marcelobns/sentinela-ip-core/docs/evidencias/alu8_circuito.png

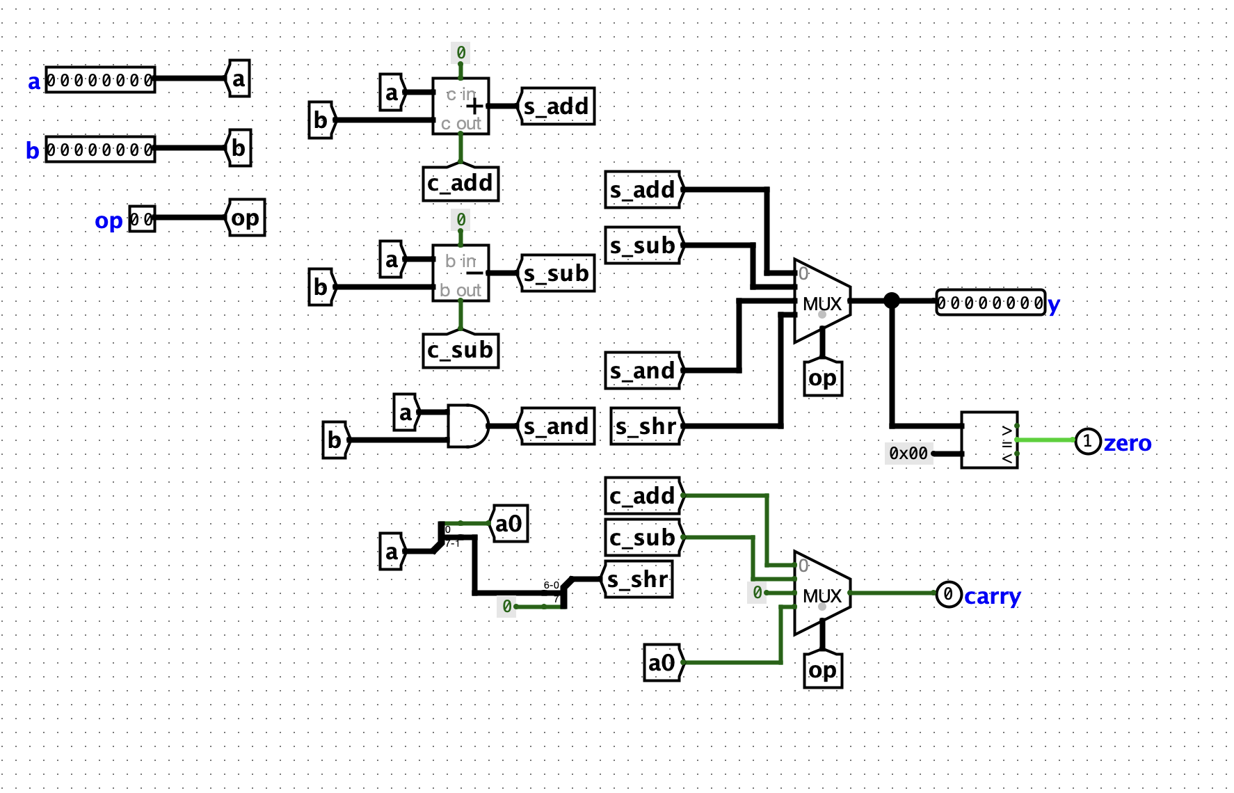
docs/evidencias/alu8_circuito.png
