marcelobns/sentinela-ip-core/docs/evidencias/fir4_circuito.png

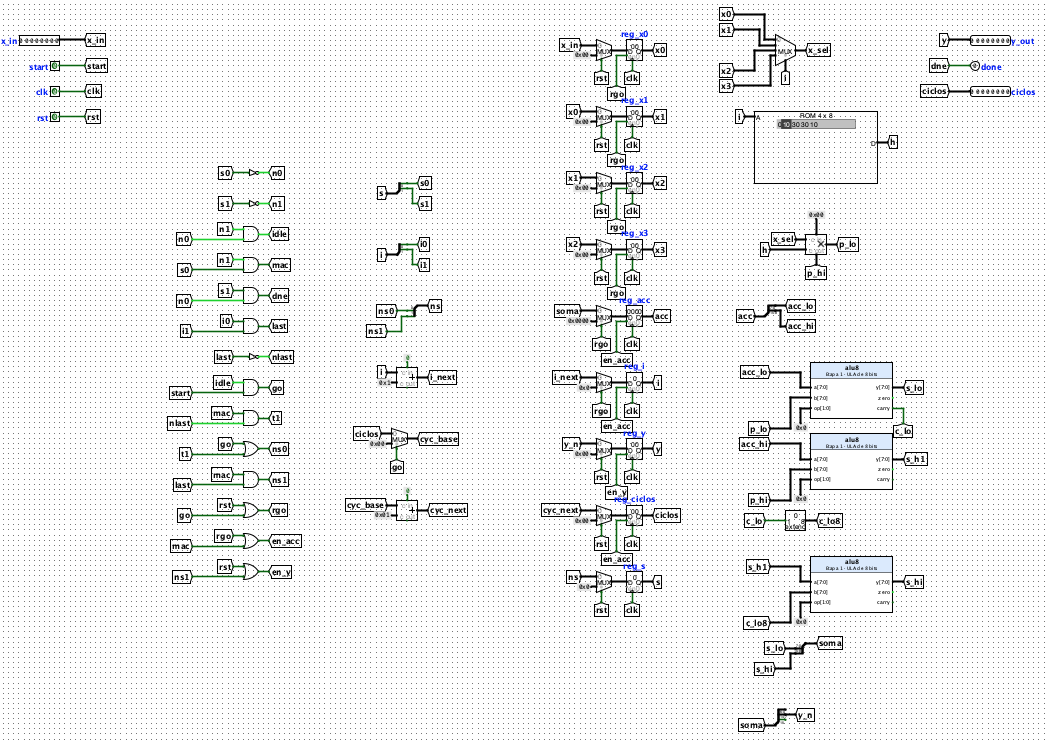
docs/evidencias/fir4_circuito.png
