marcelobns/sentinela-ip-core/docs/evidencias/intertravamento_circuito.png

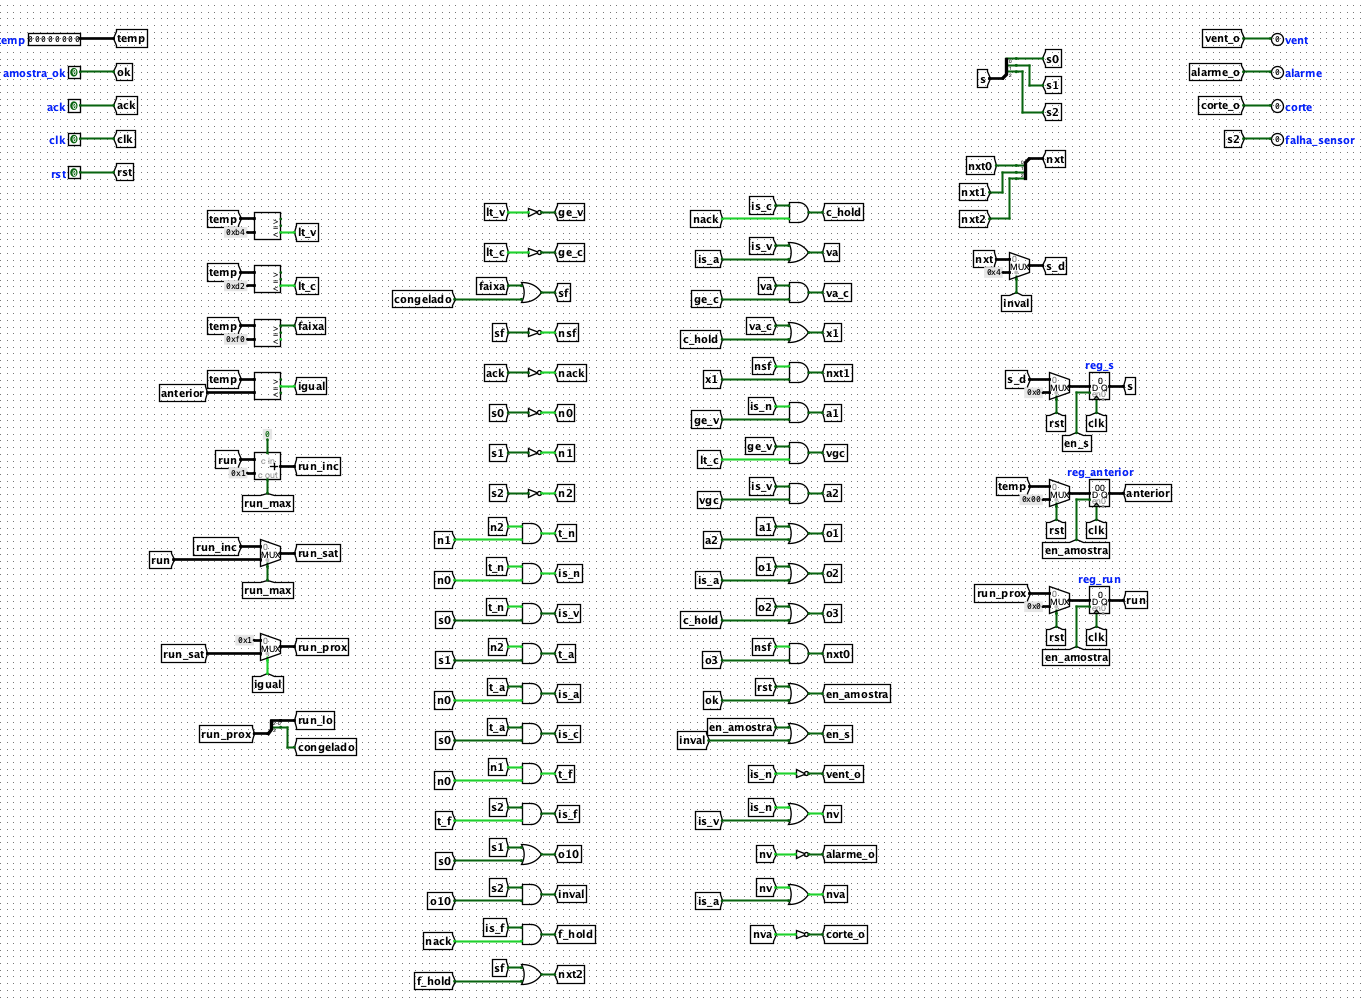
docs/evidencias/intertravamento_circuito.png
