marcelobns/sentinela-ip-core/docs/evidencias/main_1_reset.png

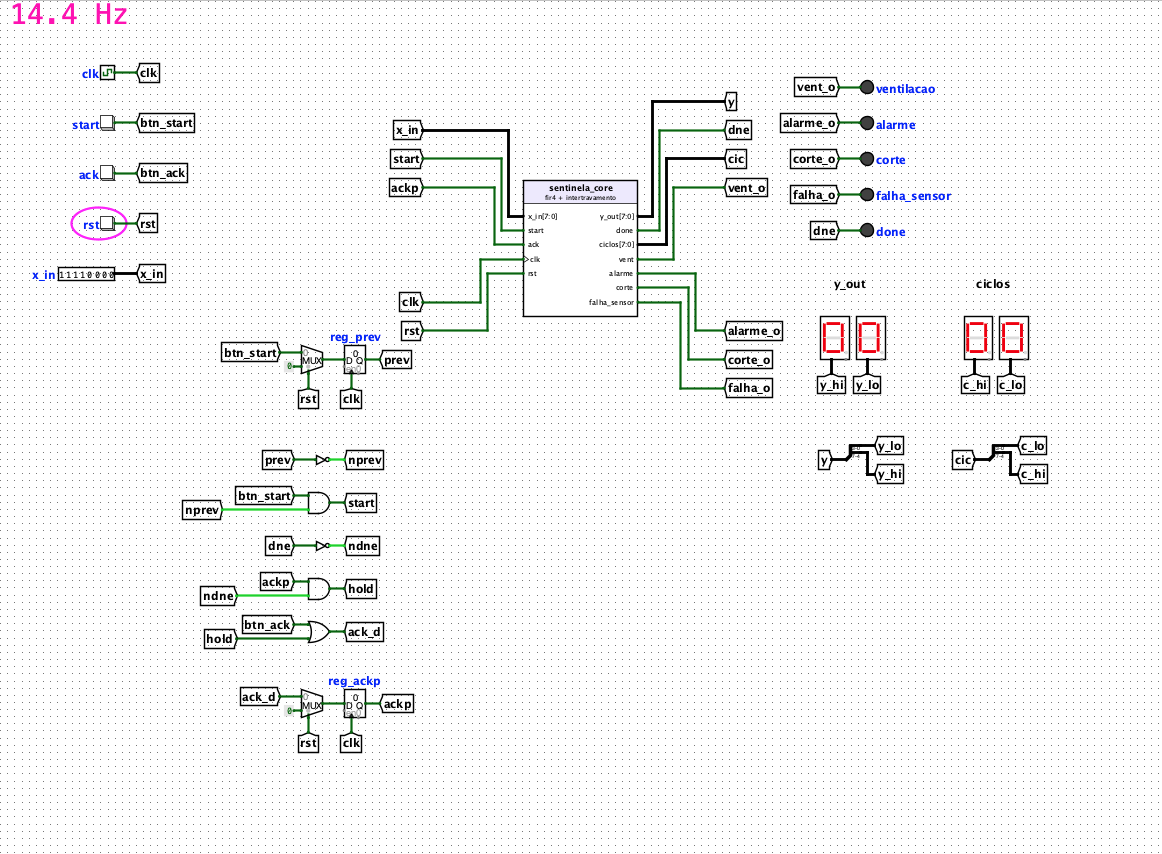
docs/evidencias/main_1_reset.png
