marcelobns/sentinela-ip-core/docs/evidencias/main_2_vent.png

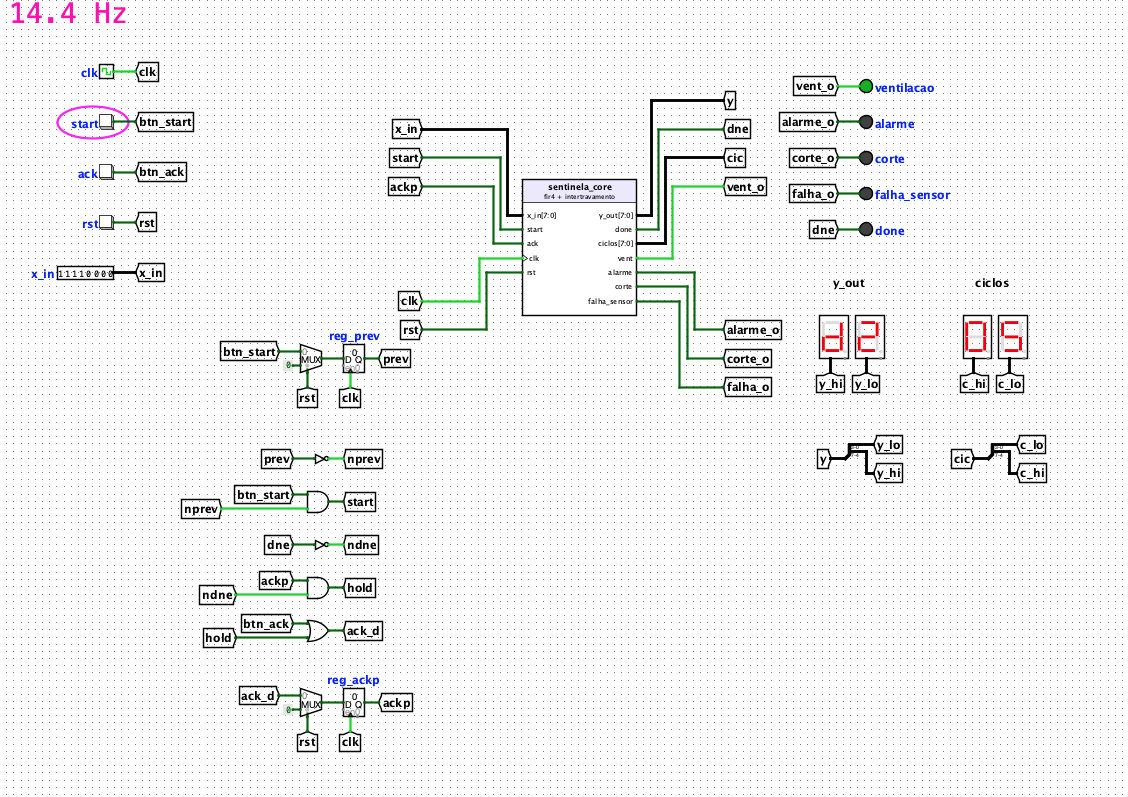
docs/evidencias/main_2_vent.png
