marcelobns/sentinela-ip-core/docs/evidencias/regs2_circuito.png

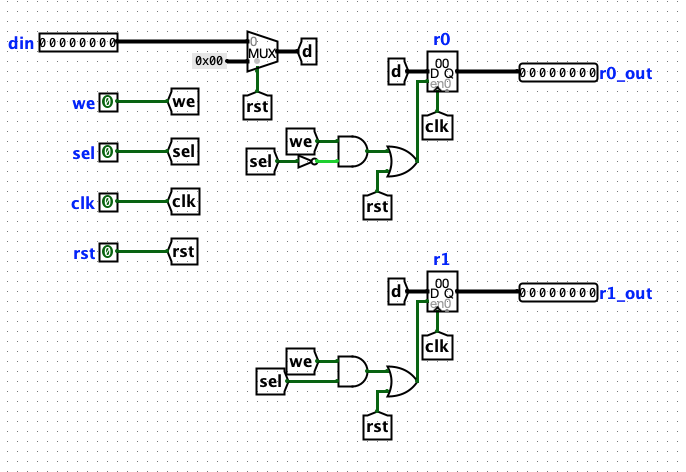
docs/evidencias/regs2_circuito.png
