marcelobns/sentinela-ip-core/docs/evidencias/sentinela_core_circuito.png

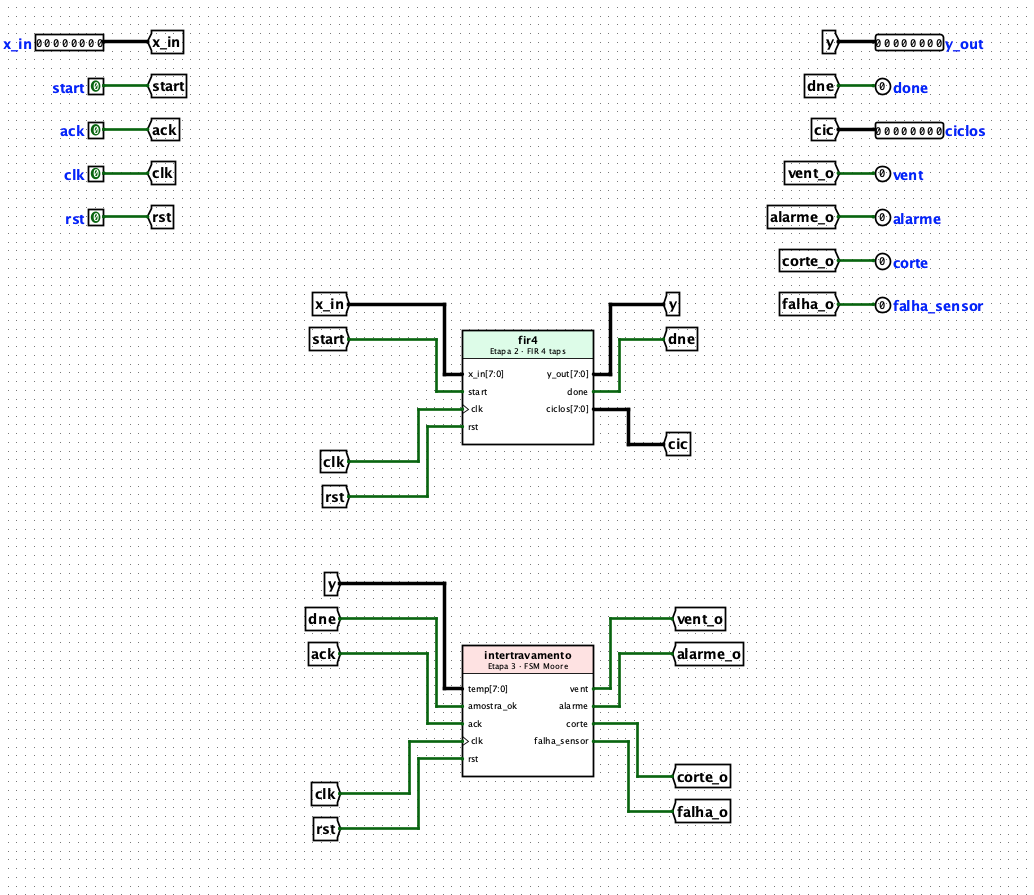
docs/evidencias/sentinela_core_circuito.png
