marcelobns/sentinela-ip-core/tests/test_fir4.txt

# test_fir4.txt — circuito fir4 (sequencial), h={16, 48, 48, 16}, latência=5
# Gerado por ref/sentinela_ref.py — não edite à mão; regenere.

x_in[8]  start  clk  rst  y_out[8]  done  ciclos[8]  <set>  <seq>
# done é verificado em todas as linhas; y_out e ciclos só enquanto done=1
# x_in fica estável durante toda a amostra; start dura 1 ciclo

# --- set 1: caso 1: 0x00, 0x00, 0x00, 0x00 -> 0x00 (reset do acumulador)
0x00     0      0    1    <DC>      0     <DC>       1      1
0x00     0      1    1    <DC>      0     <DC>       1      2      # reset síncrono
0x00     1      0    0    <DC>      0     <DC>       1      3
0x00     1      1    0    <DC>      0     <DC>       1      4      # start, x_in=0x00
0x00     0      0    0    <DC>      0     <DC>       1      5
0x00     0      1    0    <DC>      0     <DC>       1      6
0x00     0      0    0    <DC>      0     <DC>       1      7
0x00     0      1    0    <DC>      0     <DC>       1      8
0x00     0      0    0    <DC>      0     <DC>       1      9
0x00     0      1    0    <DC>      0     <DC>       1      10
0x00     0      0    0    <DC>      0     <DC>       1      11
0x00     0      1    0    0x00      1     0x05       1      12     # done=1 -> y_out=0x00 (0.0 °C), ciclos=5
0x00     0      0    0    0x00      1     0x05       1      13
0x00     0      1    0    <DC>      0     <DC>       1      14
0x00     1      0    0    <DC>      0     <DC>       1      15
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
0x64     0      1    0    0x64      1     0x05       7      108    # done=1 -> y_out=0x64 (50.0 °C), ciclos=5
0x64     0      0    0    0x64      1     0x05       7      109
0x64     0      1    0    <DC>      0     <DC>       7      110
