marcelobns/sentinela-ip-core/tests/test_fsm.txt

# test_fsm.txt — circuito intertravamento (sequencial, Moore)
# Gerado por ref/sentinela_ref.py — não edite à mão; regenere.

temp[8]  amostra_ok  ack  clk  rst  vent  alarme  corte  falha_sensor  <set>  <seq>
# T_VENT=0xB4 T_CORTE=0xD2 T_FAIXA_MAX=0xF0 N_CONGELADO=8
# Cada amostra = 1 ciclo com amostra_ok=1 seguido de 1 ciclo com amostra_ok=0 (mesmo temp): nada pode mudar sem amostra_ok
# Saídas (vent alarme corte falha): NORMAL 0000, VENT 1000, ALARME 1100, CORTE 1110, FALHA 1111

# --- set 1: caso 1: 0x60, 0x70, 0x80 -> permanece NORMAL
0x00     0           0    0    1    0     0       0      0             1      1
0x00     0           0    1    1    0     0       0      0             1      2      # reset síncrono
0x60     1           0    0    0    0     0       0      0             1      3
0x60     1           0    1    0    0     0       0      0             1      4      # temp=0x60 -> NORMAL
0x60     0           0    0    0    0     0       0      0             1      5
0x60     0           0    1    0    0     0       0      0             1      6
0x70     1           0    0    0    0     0       0      0             1      7
0x70     1           0    1    0    0     0       0      0             1      8      # temp=0x70 -> NORMAL
0x70     0           0    0    0    0     0       0      0             1      9
0x70     0           0    1    0    0     0       0      0             1      10
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
0xD5     0           0    1    0    1     1       1      0             21     14
0xD5     0           0    0    1    1     1       1      0             21     15
0xD5     0           0    1    1    0     0       0      0             21     16     # rst -> NORMAL
