marcelobns/sentinela-ip-core/tests/test_sentinela.txt

# test_sentinela.txt — circuito sentinela_core (fir4 + intertravamento; caso 10)
# Gerado por ref/sentinela_ref.py — não edite à mão; regenere.

x_in[8]  start  ack  clk  rst  y_out[8]  done  ciclos[8]  vent  alarme  corte  falha_sensor  <set>  <seq>
# fir4.y_out -> intertravamento.temp; fir4.done -> intertravamento.amostra_ok
# Saídas do intertravamento verificadas em todas as linhas

# --- set 1: caso 10: 0x64, 0x64, 0xFF, 0x64 -> pico isolado não dispara VENT
0x00     0      0    0    1    <DC>      0     <DC>       0     0       0      0             1      1
0x00     0      0    1    1    <DC>      0     <DC>       0     0       0      0             1      2      # reset síncrono
0x64     1      0    0    0    <DC>      0     <DC>       0     0       0      0             1      3
0x64     1      0    1    0    <DC>      0     <DC>       0     0       0      0             1      4      # start, x_in=0x64
0x64     0      0    0    0    <DC>      0     <DC>       0     0       0      0             1      5
0x64     0      0    1    0    <DC>      0     <DC>       0     0       0      0             1      6
0x64     0      0    0    0    <DC>      0     <DC>       0     0       0      0             1      7
0x64     0      0    1    0    <DC>      0     <DC>       0     0       0      0             1      8
0x64     0      0    0    0    <DC>      0     <DC>       0     0       0      0             1      9
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
0xF0     1      0    1    0    <DC>      0     <DC>       0     0       0      0             3      76     # start, x_in=0xF0
0xF0     0      0    0    0    <DC>      0     <DC>       0     0       0      0             3      77
0xF0     0      0    1    0    <DC>      0     <DC>       0     0       0      0             3      78
0xF0     0      0    0    0    <DC>      0     <DC>       0     0       0      0             3      79
0xF0     0      0    1    0    <DC>      0     <DC>       0     0       0      0             3      80
0xF0     0      0    0    0    <DC>      0     <DC>       0     0       0      0             3      81
0xF0     0      0    1    0    <DC>      0     <DC>       0     0       0      0             3      82
0xF0     0      0    0    0    <DC>      0     <DC>       0     0       0      0             3      83
0xF0     0      0    1    0    0xF0      1     0x05       0     0       0      0             3      84     # done=1 -> y_out=0xF0 (120.0 °C), ciclos=5
0xF0     0      0    0    0    0xF0      1     0x05       0     0       0      0             3      85
0xF0     0      0    1    0    <DC>      0     <DC>       1     0       0      0             3      86
