marcelobns/sentinela-ip-core/docs/evidencias/alu8_test.png

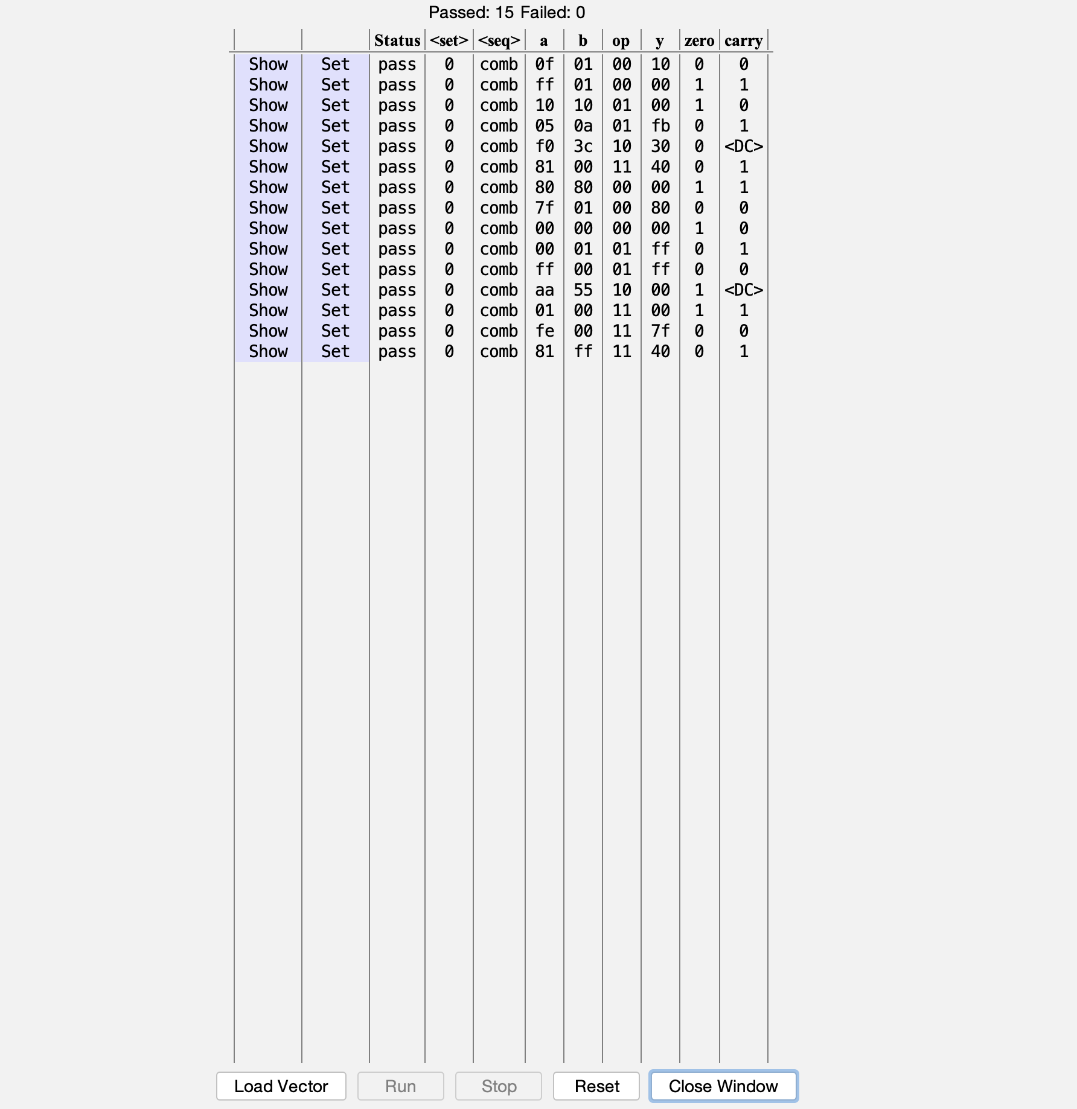
docs/evidencias/alu8_test.png
