marcelobns/sentinela-ip-core/docs/evidencias/fir4_test.png

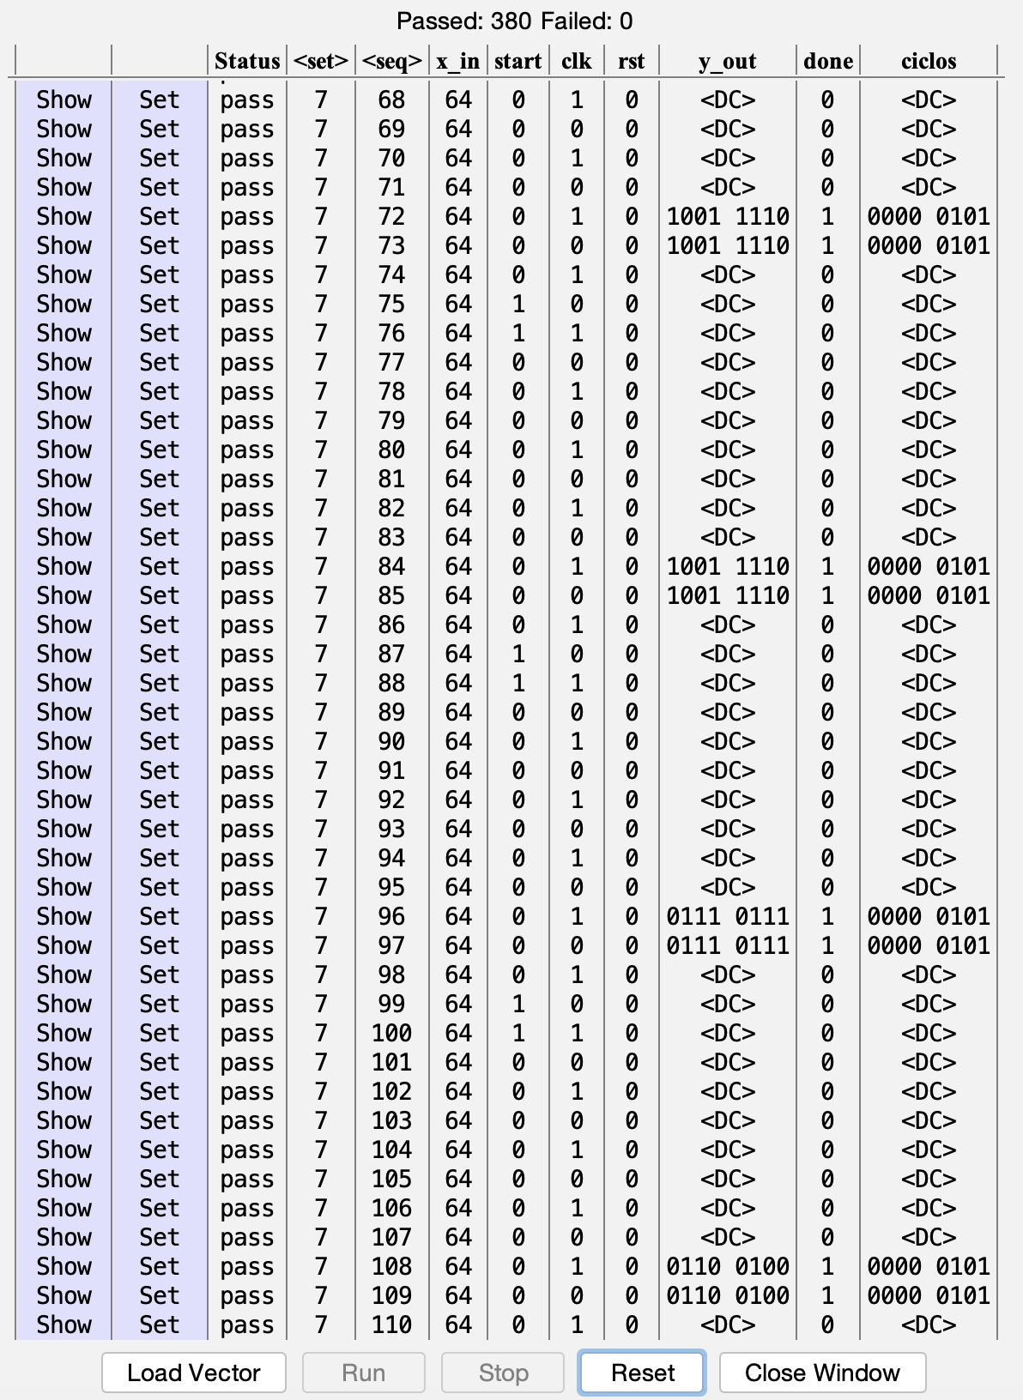
docs/evidencias/fir4_test.png
