marcelobns/sentinela-ip-core/docs/evidencias/intertravamento_test.png

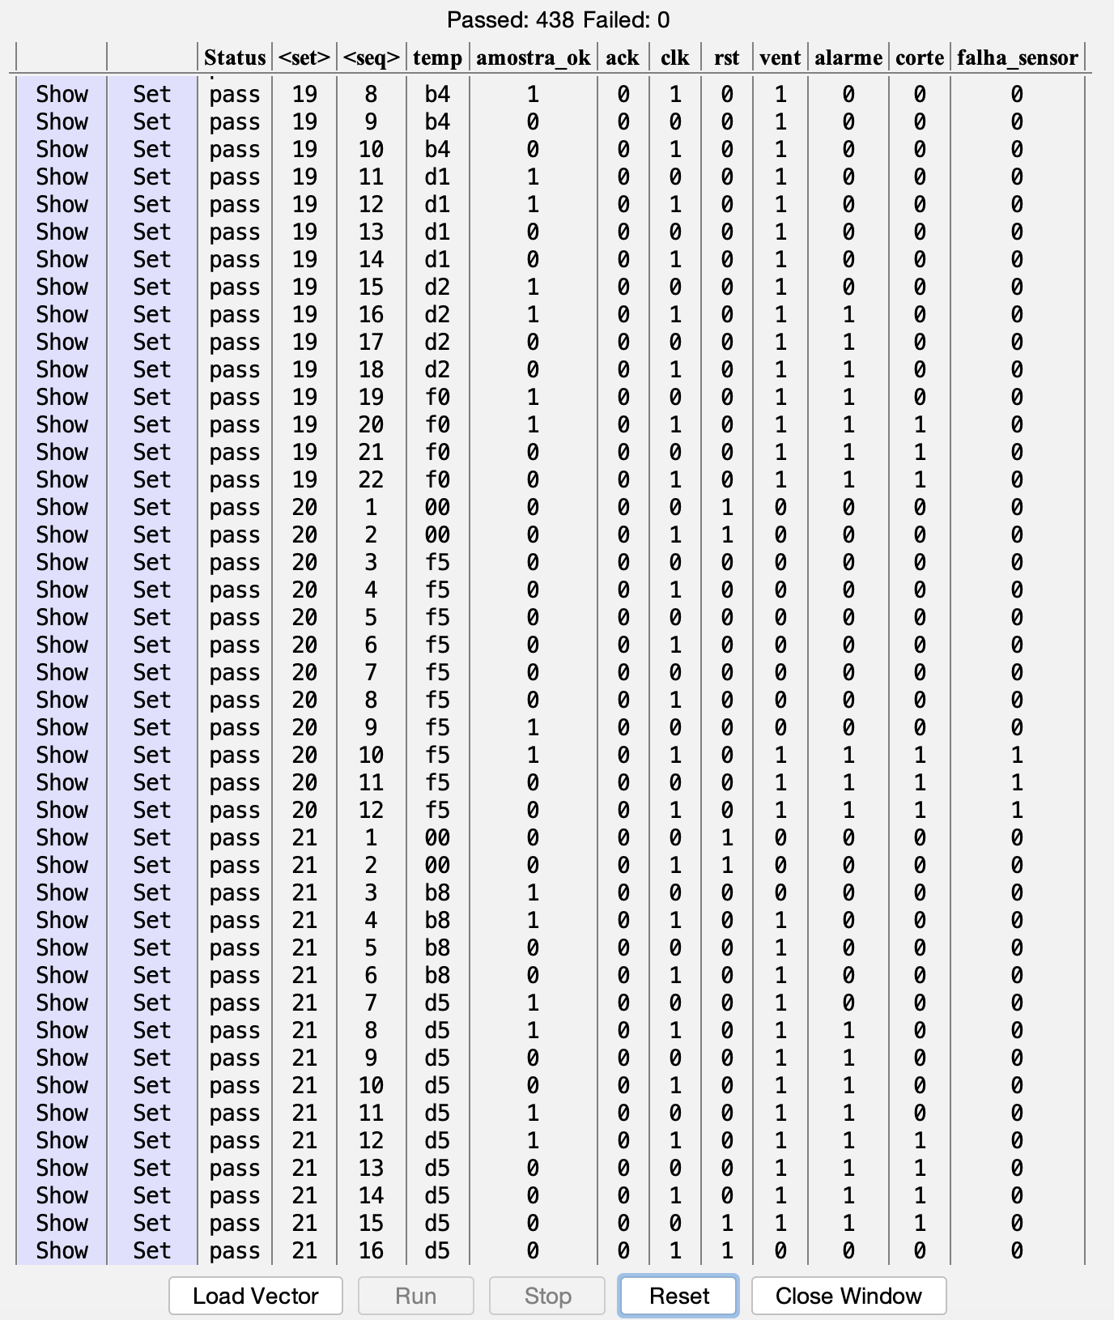
docs/evidencias/intertravamento_test.png
