marcelobns/sentinela-ip-core/docs/evidencias/regs2_test.png

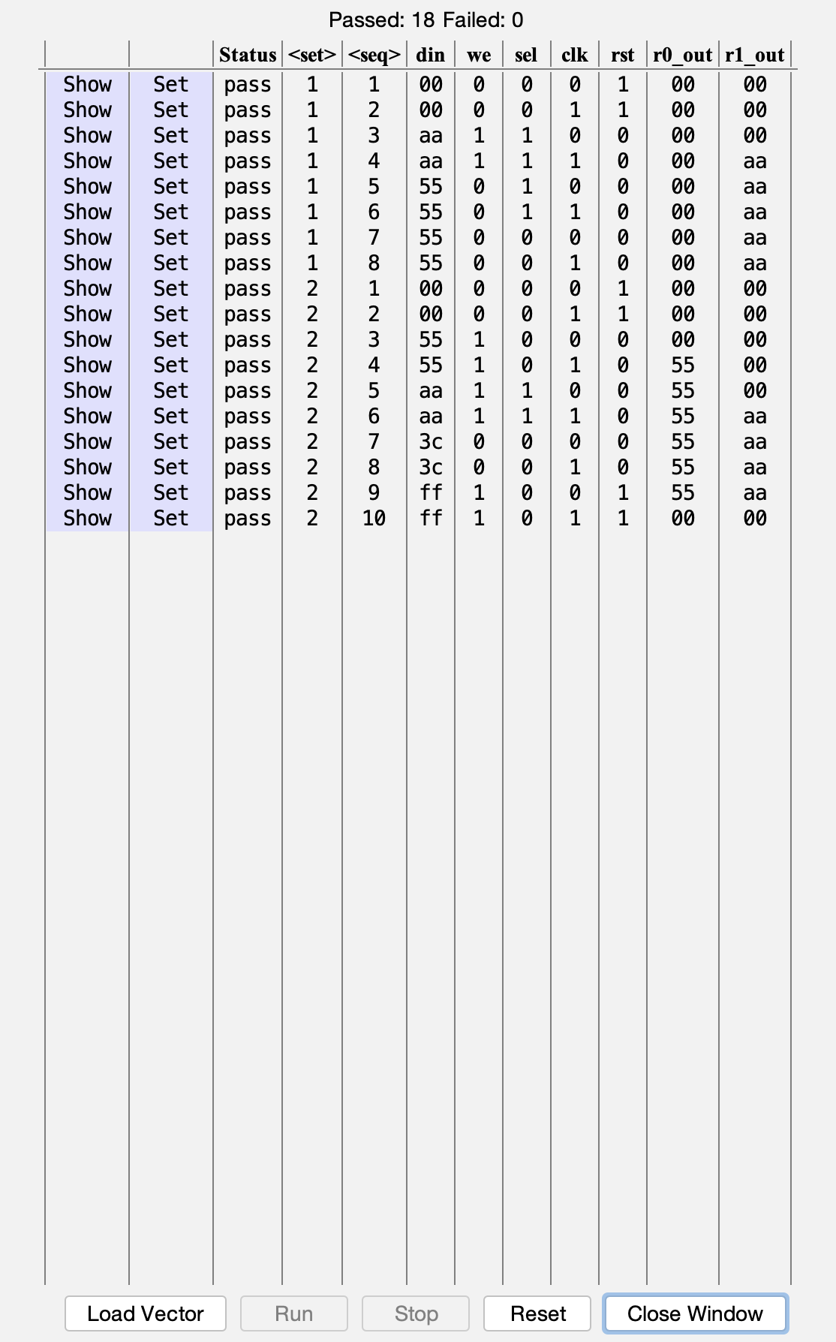
docs/evidencias/regs2_test.png
