marcelobns/sentinela-ip-core/docs/evidencias/sentinela_core_test.png

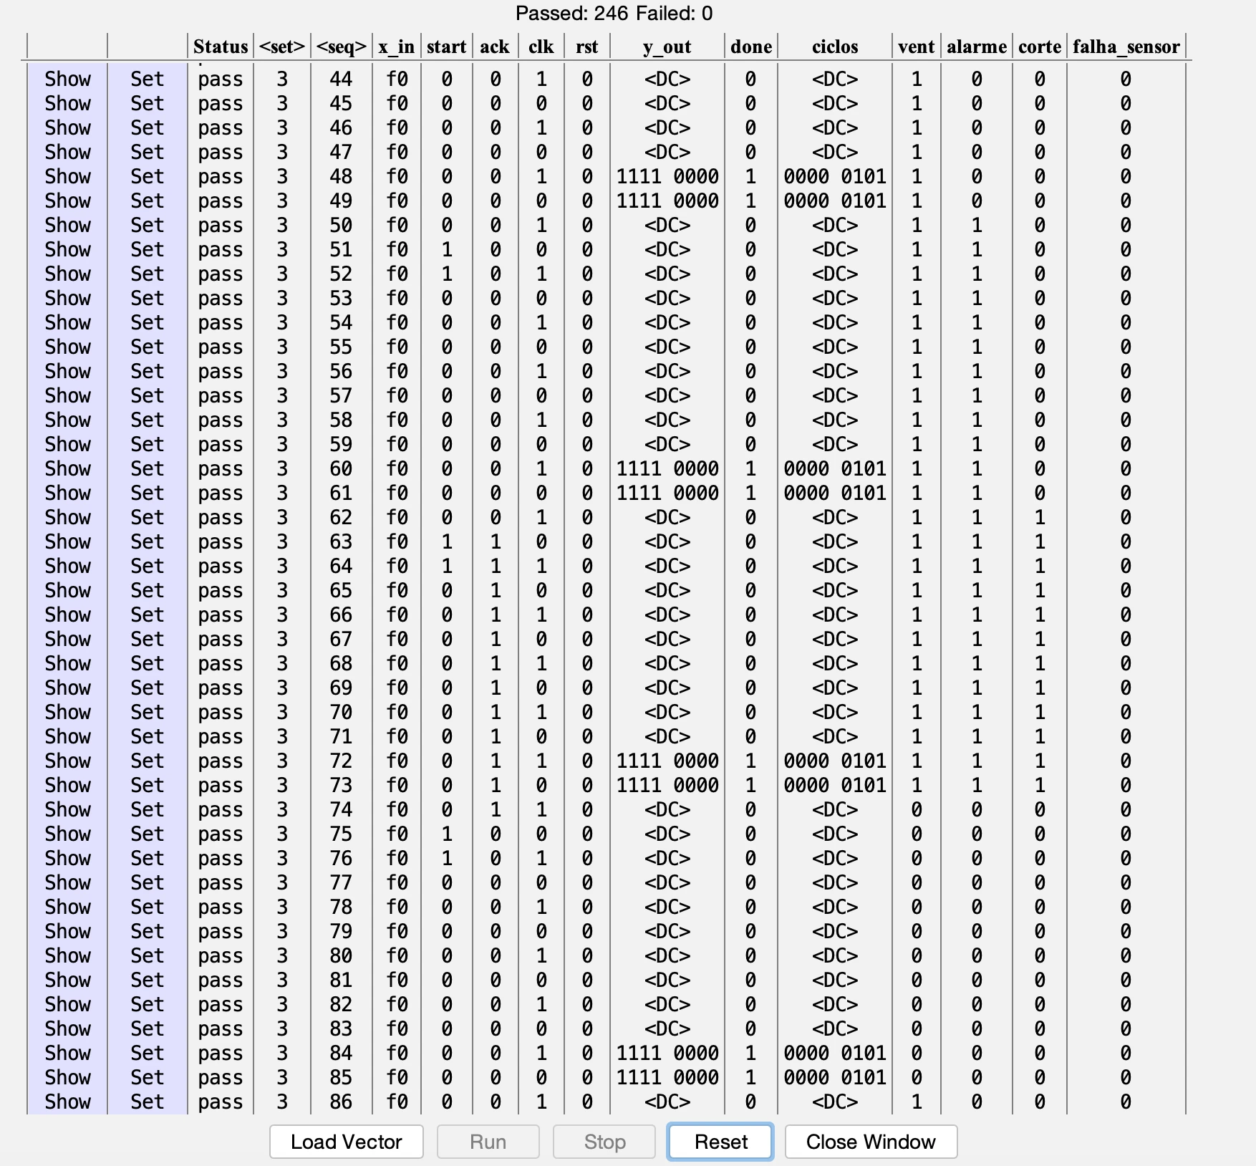
docs/evidencias/sentinela_core_test.png
