marcelobns/sentinela-ip-core/(list of files, drawings)

Other design files:
sentinela.circ
