marcelobns/sentinela-ip-core/(commit log)

2026-11-03 SENTINELA: subcircuitos, vetores de teste, modelo de referência e documentação
    alu8, regs2, fir4, intertravamento, sentinela_core e main implementados em
    sentinela.circ (Logisim-evolution 5.0.0). 1097/1097 vetores passando.
    [sentinela.circ]
2026-11-03 Geradores do sentinela.circ e aparência personalizada dos subcircuitos
    Versiona tools/: os scripts que geram cada subcircuito (build_*.py), as
    células de layout, o lint e a bancada de teste do main.
    Cada subcircuito ganha uma aparência personalizada gerada pelo script:
    nome e etapa no cabeçalho, entradas à esquerda e saídas à direita a cada
    20 px, com a largura do barramento no rótulo. Quem instancia um
    subcircuito lê as portas dessa aparência no próprio .circ, em vez de
    usar coordenadas fixas.
    A aparência não usa <line>: no Logisim 5.0.0, Line.paint estoura
    NullPointerException ao desenhar a instância e o canvas fica em branco.
    Os LEDs do main passam a ter rótulos válidos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
    [sentinela.circ]
2026-11-03 Atualiza o status da entrega no README e no PRD
    Marca a aparência personalizada como feita e remove do README a nota
    sobre subcircuitos vazios, que não vale mais.
2026-11-03 Registra a dupla e a ponte com o PTT4 (SenseBridge)
    O laboratório é feito pela mesma dupla do PTT4: Ezequias Carlos Ferreira
    da Silva e Marcelo Gomes Barbosa. O PRD passa a citar o SenseBridge como
    destino do intertravamento e registra o resultado já colhido: a análise
    do detector de congelamento levou ao detector opcional de leitura
    congelada do SenseBridge (ADR-010 / D14 de lá).
2026-11-03 Relatório da entrega (docx)
    Duas páginas A4, corpo em 11 pt: entrega e verificação, decisões e
    reflexivas das Etapas 1 a 3, tabela de transição da FSM, discussão sobre
    o corte em FALHA e ponte para o PTT4. Doze referências em ABNT, com os
    livros na edição mais recente e os DOIs dos artigos clicáveis. Os itens
    em aberto do roteiro seguem marcados com [VERIFICAR].
    O docx é a fonte do relatório; o PDF é exportado na entrega. O
    .gitignore passa a ignorar os temporários do Word.
2026-11-03 Lista de pontos a confirmar com o professor
    docs/verificar_professor.md reúne, por prioridade, os 14 pontos em aberto
    do roteiro: a errata do caso 5, as decisões que afetam os vetores (D7,
    D8, D9, D10/D11), as de ferramenta e forma (D16, D4, D15, D13) e as de
    escopo e entrega (Etapa 4, bônus, Etapa final, formato do relatório).
    Cada item traz o que o roteiro diz, o que fizemos e a pergunta. README e
    PRD apontam para a lista.
2026-11-03 Barra de ferramentas e atalhos de mouse no sentinela.circ
    O arquivo gerado não tinha as seções <toolbar> e <mappings>, e o
    Logisim 5.0.0 abria com a barra só com "Add main", sem a ferramenta de
    mão (Poke) para operar o main. As duas seções vêm do modelo padrão da
    própria 5.0.0 (default.templ). Os scripts de tools/ só substituem os
    blocos <circuit>, então a barra sobrevive à regeneração.
    O .gitignore passa a ignorar os autosaves do Logisim.
    [sentinela.circ]
2026-11-03 Evidências: prints dos Test Vectors, dos circuitos e do main
    docs/evidencias/ guarda os prints exigidos pelo roteiro, tirados no GUI
    do Logisim 5.0.0: os cinco Test Vectors, todos sem falhas (alu8 15,
    regs2 18, fir4 380, intertravamento 438, sentinela_core 246), e o main
    em CORTE com ciclos = 05. Também os circuitos de cada subcircuito e a
    sequência do main: reset, VENT, ALARME e o falso positivo do detector
    de congelamento (FALHA com x_in constante). O README marca os dois
    itens de evidência como feitos.
2026-11-03 Renomeia os prints para o formato <subcircuito>_<tipo>
    alu8_circuito, alu8_test e assim por diante; o print do Test Vector do intertravamento passa a se chamar intertravamento_test, pelo nome do subcircuito. O README acompanha os novos nomes.
2026-11-03 README e PRD prontos para a entrega
    O README corrige as instruções do main: os botões precisam ficar
    pressionados por uma borda de relógio, a ferramenta é a de mão (Poke) e
    os menus da 5.0.0 se chamam Auto-Tick. Também passa a usar a sigla
    PPCA/UFRR, aponta para o relatório em PDF e marca o item como feito. O
    PRD atualiza o estado atual, os bloqueios, os riscos e o roadmap: falta
    só confirmar os pontos em aberto com o professor.
2026-11-03 README no formato do mini8-processor
    Mesma estrutura do README do mini8-processor: tabela de autores,
    disciplina, professor e data, bloco de validação, imagem do main e
    linha de links, seguidos de Proposta, Subcircuitos, Execução dos
    testes, Operação do main, Regeneração, Entregáveis e Status de
    verificação. A árvore de arquivos e os detalhes dos geradores saem; os
    caminhos aparecem nos links e nos entregáveis. O link do 02-arch para a
    tabela de pinos acompanha a nova seção.
